cjlord/KiCad_CEC_ESC_NFC/README.md

# KiCad_CEC_ESC_NFC
Repository for the KiCad class taught on Design News CEC and the ESC NFC tutorial

Expect the KiCad class files to be loaded by about March 10, 2019.
