cjlord/KiCad_CEC_ESC_NFC/CEC01/CEC01.kicad_pcb

## KiCad design CEC01/CEC01.kicad_pcb (2019-03-01)

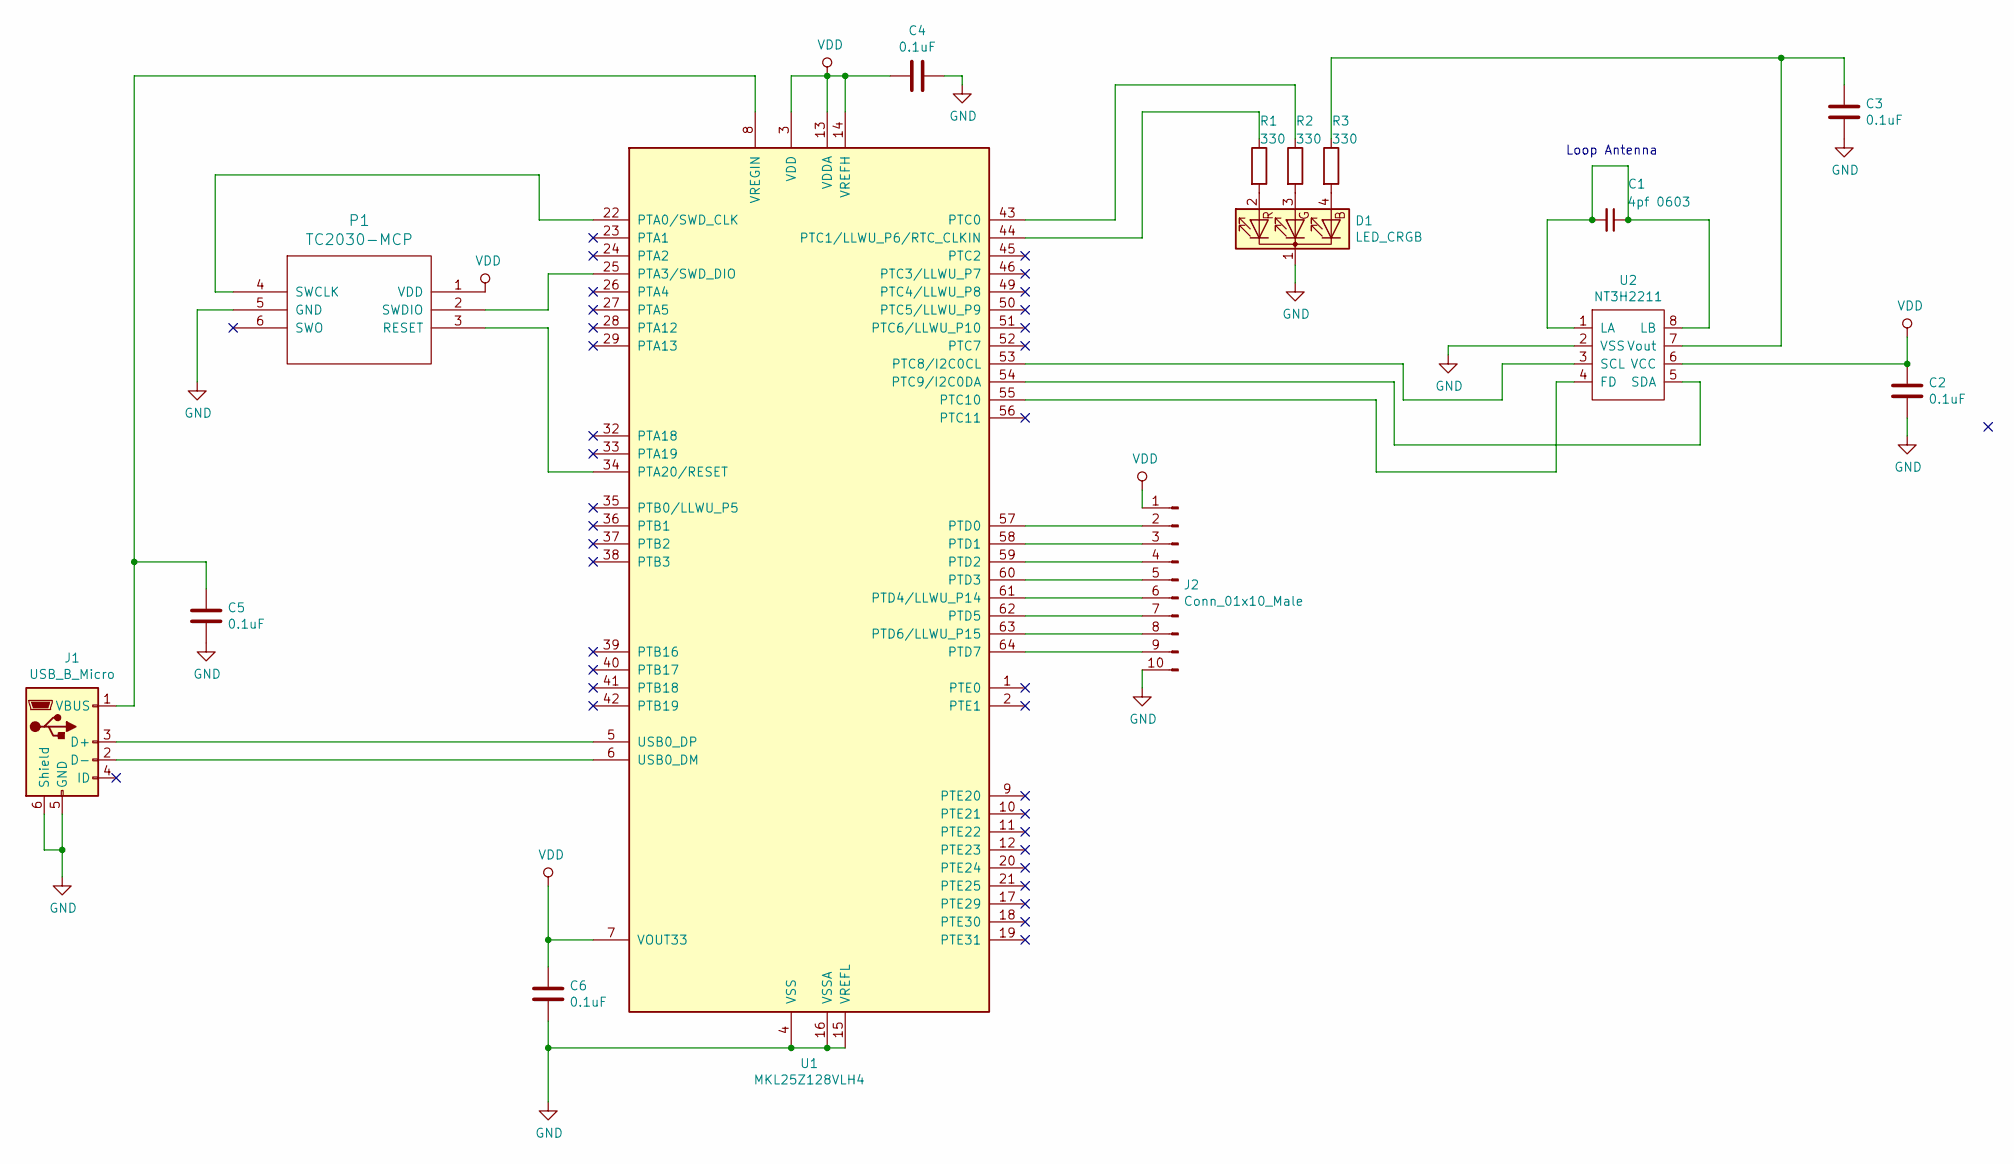
[picture p1: schematic CEC01.sch, CEC / ESC NFC Tag]

Parts:
C1: 4pf 0603; C_0603_1608Metric
C2, C3, C4, C5, C6: 0.1uF; C_0603_1608Metric
D1: LED_CRGB; LED_D5.0mm-4_RGB
J1: USB_B_Micro; 10104110-0001LF
J2: Conn_01x10_Male; PinHeader_1x10_P2.54mm_Vertical
P1: TC2030-MCP; Tag-Connect_TC2030-IDC-FP_2x03_P1.27mm_Vertical
R1, R2, R3: 330; R_0603_1608Metric
U1: MKL25Z128VLH4; LQFP-64_10x10mm_P0.5mm
U2: NT3H2211; SO-8_5.3x6.2mm_P1.27mm

Connections:
GND: C2.2, C3.2, C4.1, C5.2, C6.2, D1.1 (K), J1.5 (GND), J1.6 (Shield), J2.10, P1.5 (GND), U1.4 (VSS), U1.15 (VREFL), U1.16 (VSSA), U1.31 (VSS), U1.47 (VSS), U2.2 (VSS)
unnamed: C1.1, C1.2, U2.1 (LA), U2.8 (LB)
unnamed: C3.1, R3.1, U2.7 (Vout)
unnamed: C5.1, J1.1 (VBUS), U1.8 (VREGIN)
unnamed: D1.2 (RA), R1.2
unnamed: D1.3 (GA), R2.2
unnamed: D1.4 (BA), R3.2
unnamed: J1.2 (D-), U1.6 (USB0_DM)
unnamed: J1.3 (D+), U1.5 (USB0_DP)
unnamed: J2.2, U1.57 (PTD0)
unnamed: J2.3, U1.58 (PTD1)
unnamed: J2.4, U1.59 (PTD2)
unnamed: J2.5, U1.60 (PTD3)
unnamed: J2.6, U1.61 (PTD4/LLWU_P14)
unnamed: J2.7, U1.62 (PTD5)
unnamed: J2.8, U1.63 (PTD6/LLWU_P15)
unnamed: J2.9, U1.64 (PTD7)
unnamed: P1.2 (SWDIO), U1.25 (PTA3/SWD_DIO)
unnamed: P1.3 (RESET), U1.34 (PTA20/RESET)
unnamed: P1.4 (SWCLK), U1.22 (PTA0/SWD_CLK)
unnamed: R1.1, U1.44 (PTC1/LLWU_P6/RTC_CLKIN)
unnamed: R2.1, U1.43 (PTC0)
unnamed: U1.53 (PTC8/I2C0CL), U2.3 (SCL)
unnamed: U1.54 (PTC9/I2C0DA), U2.5 (SDA)
unnamed: U1.55 (PTC10), U2.4 (FD)
VDD: C2.1, C4.2, C6.1, J2.1, P1.1 (VDD), U1.3 (VDD), U1.7 (VOUT33), U1.13 (VDDA), U1.14 (VREFH), U1.30 (VDD), U1.48 (VDD), U2.6 (VCC)

Notes on the sheet:
Loop Antenna

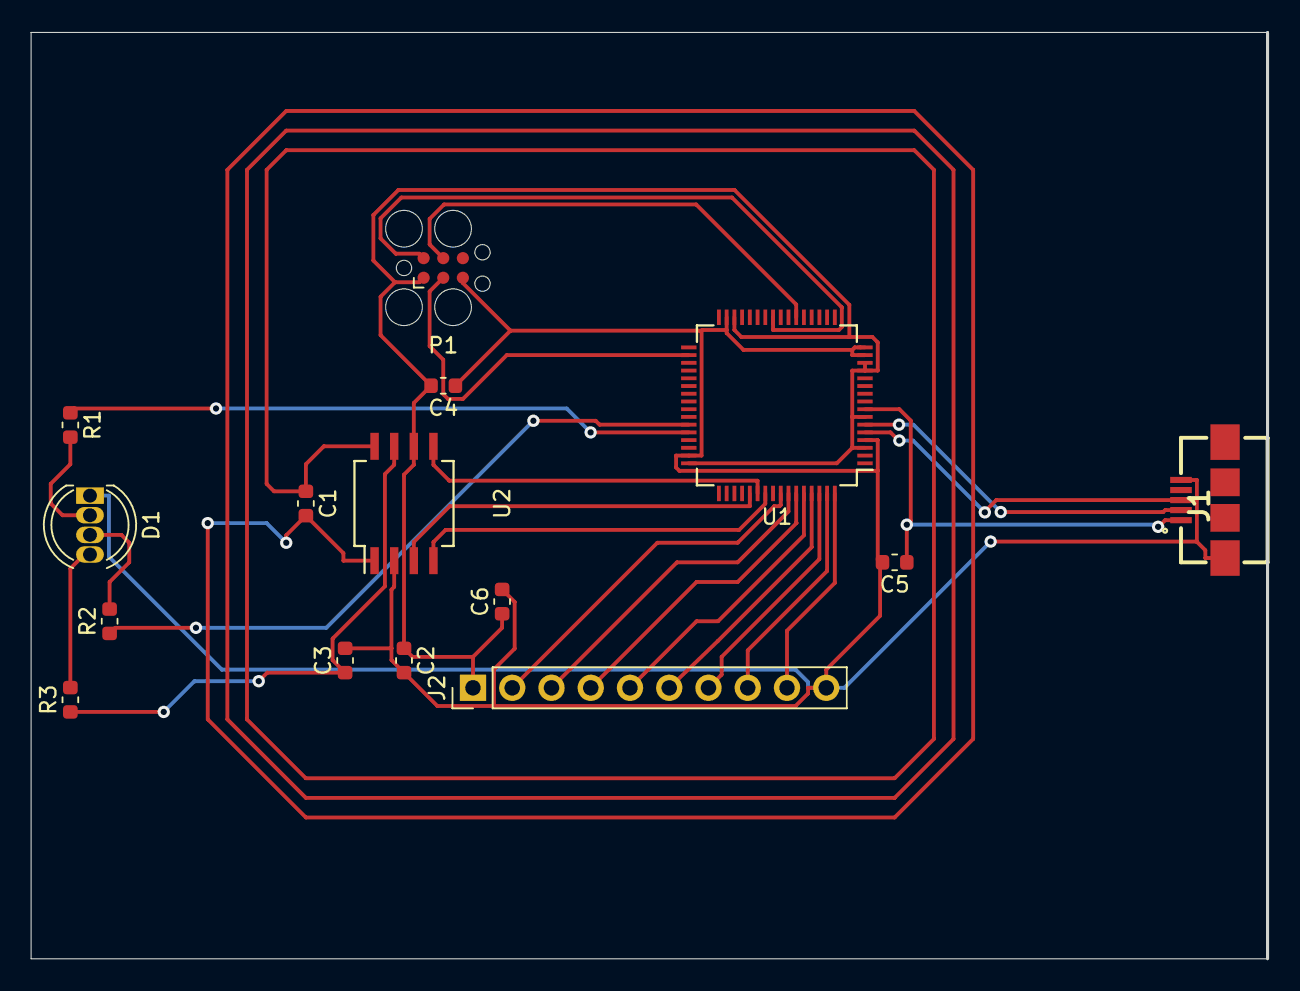
[picture p2: board CEC01.kicad_pcb from above]

Board: 2 copper layers, 80.0 x 59.9 mm, 15 parts (0 on the bottom side), 26 nets.
